max234252/TechStep/TechStep_Keypad/Bottom.jpg

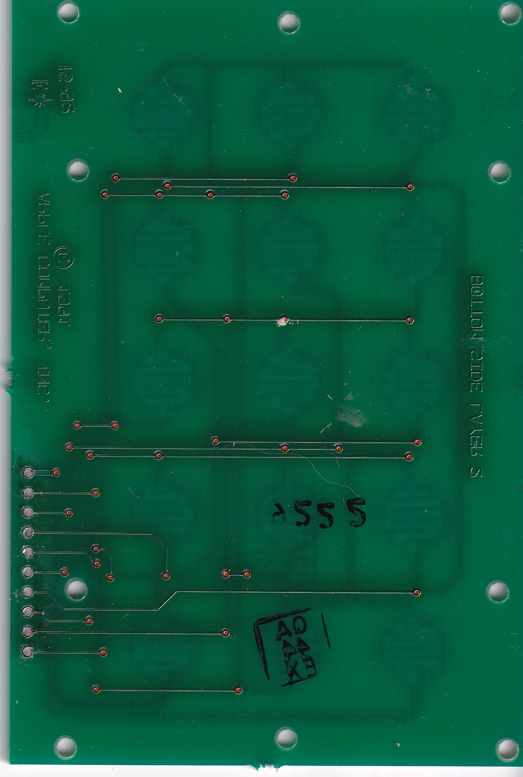
TechStep_Keypad/Bottom.jpg
