max234252/TechStep/Scans/Port Pack Scans/Bottom_Bottom.jpg

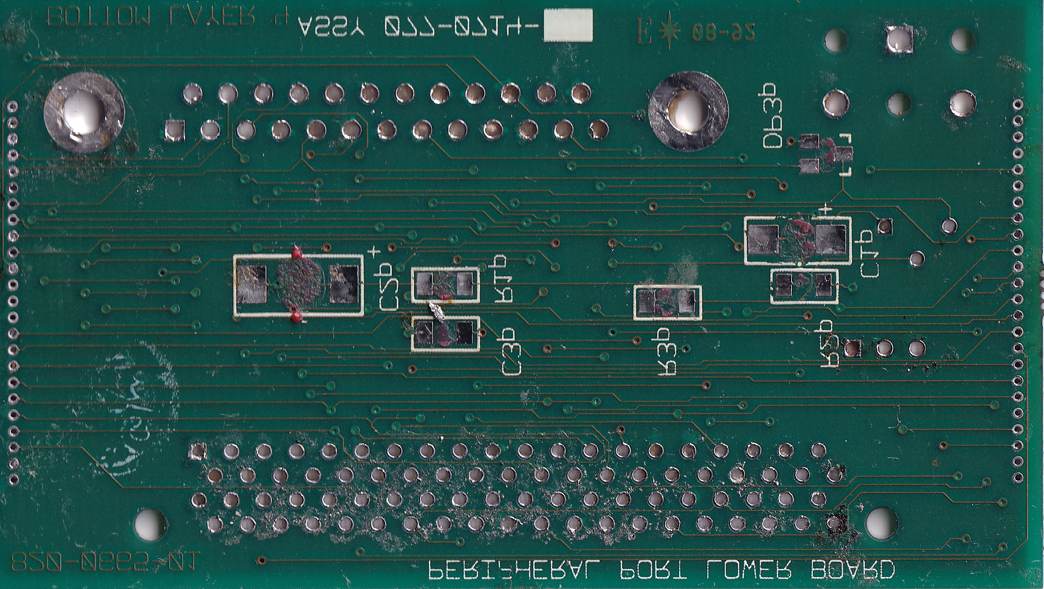
Scans/Port Pack Scans/Bottom_Bottom.jpg
