max234252/TechStep/Scans/Port Pack Scans/Bottom_Top.jpg

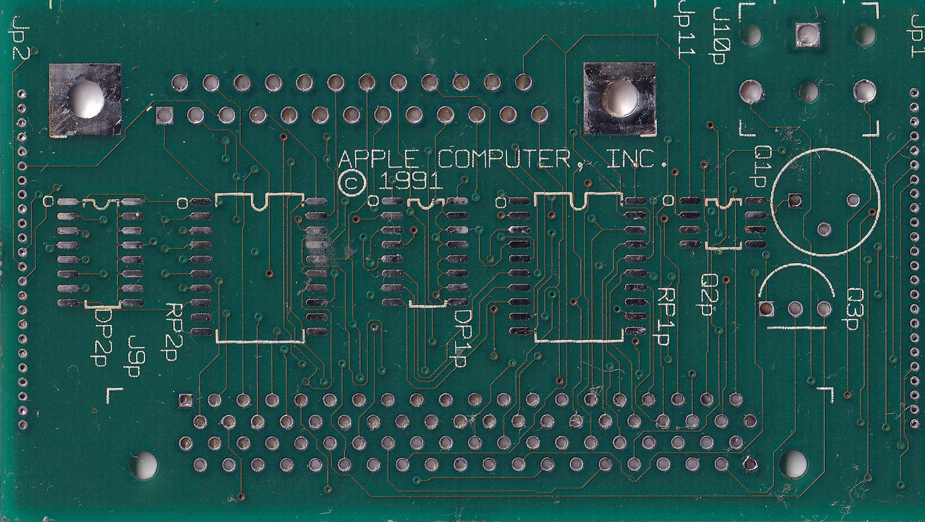
Scans/Port Pack Scans/Bottom_Top.jpg
