max234252/TechStep/Scans/Port Pack Scans/Top_Bottom.jpg

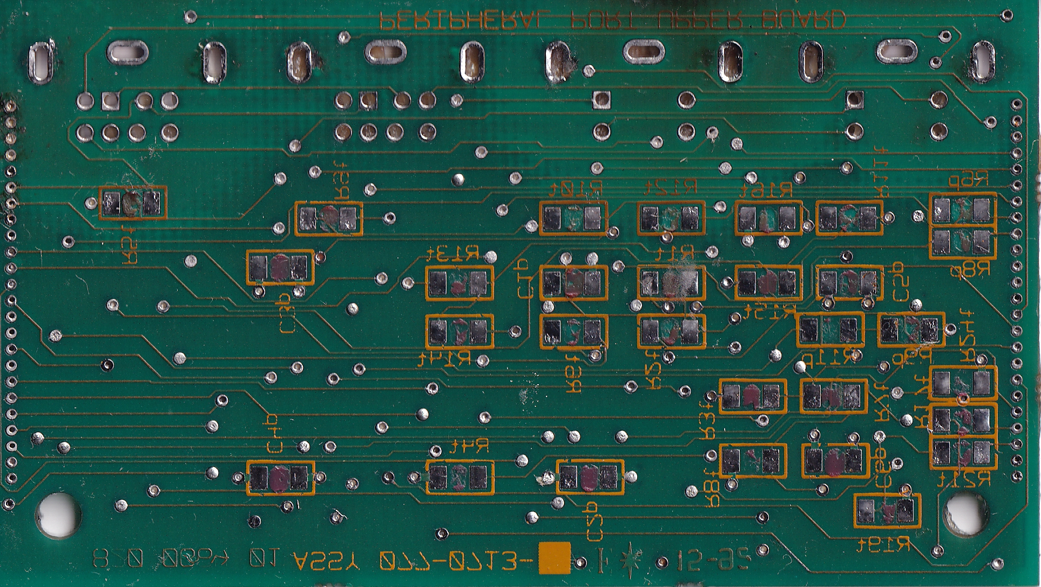
Scans/Port Pack Scans/Top_Bottom.jpg
