max234252/TechStep/Scans/Port Pack Scans/Top_Top.jpg

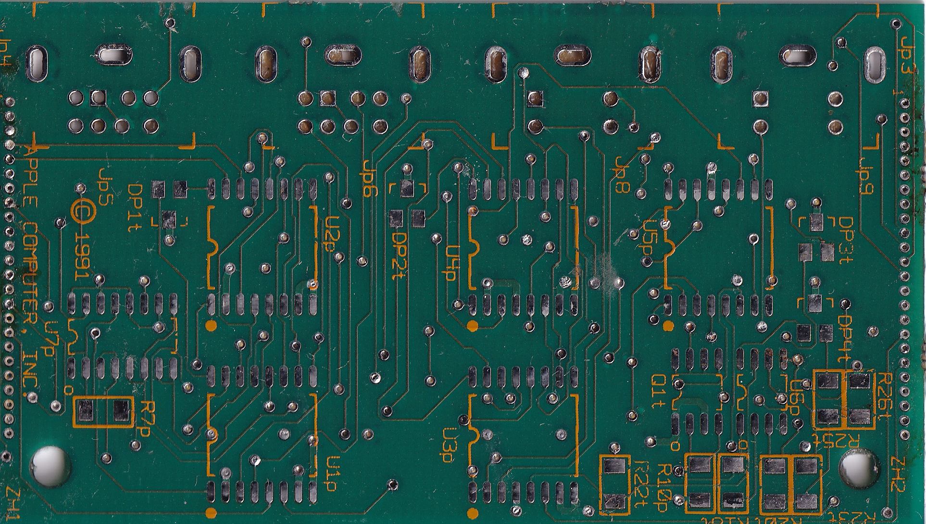
Scans/Port Pack Scans/Top_Top.jpg
