max234252/TechStep/TechStep_MLB - V1.2A - 16-09-22.pdf

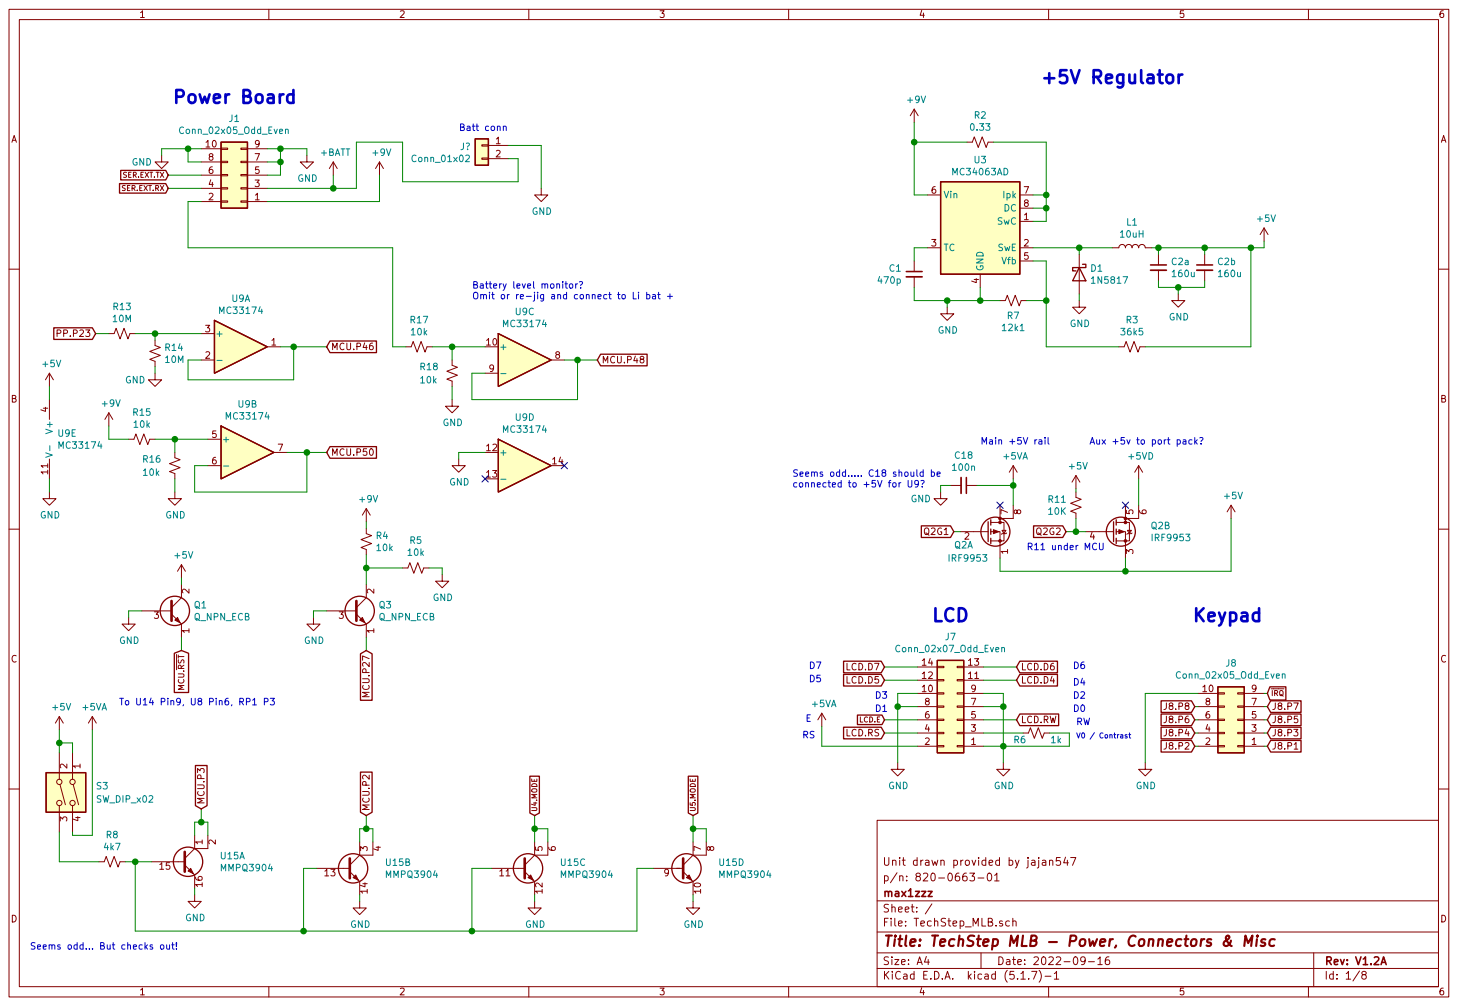
[picture p6: page 1]

Batt conn Power Board

Aux +5v to port pack?

Unit drawn provided by jajan547
File: TechStep_MLB.sch Sheet: / max1zzz p/n: 820-0663-01

Id: 1/8 Title: TechStep MLB - Power, Connectors & Misc

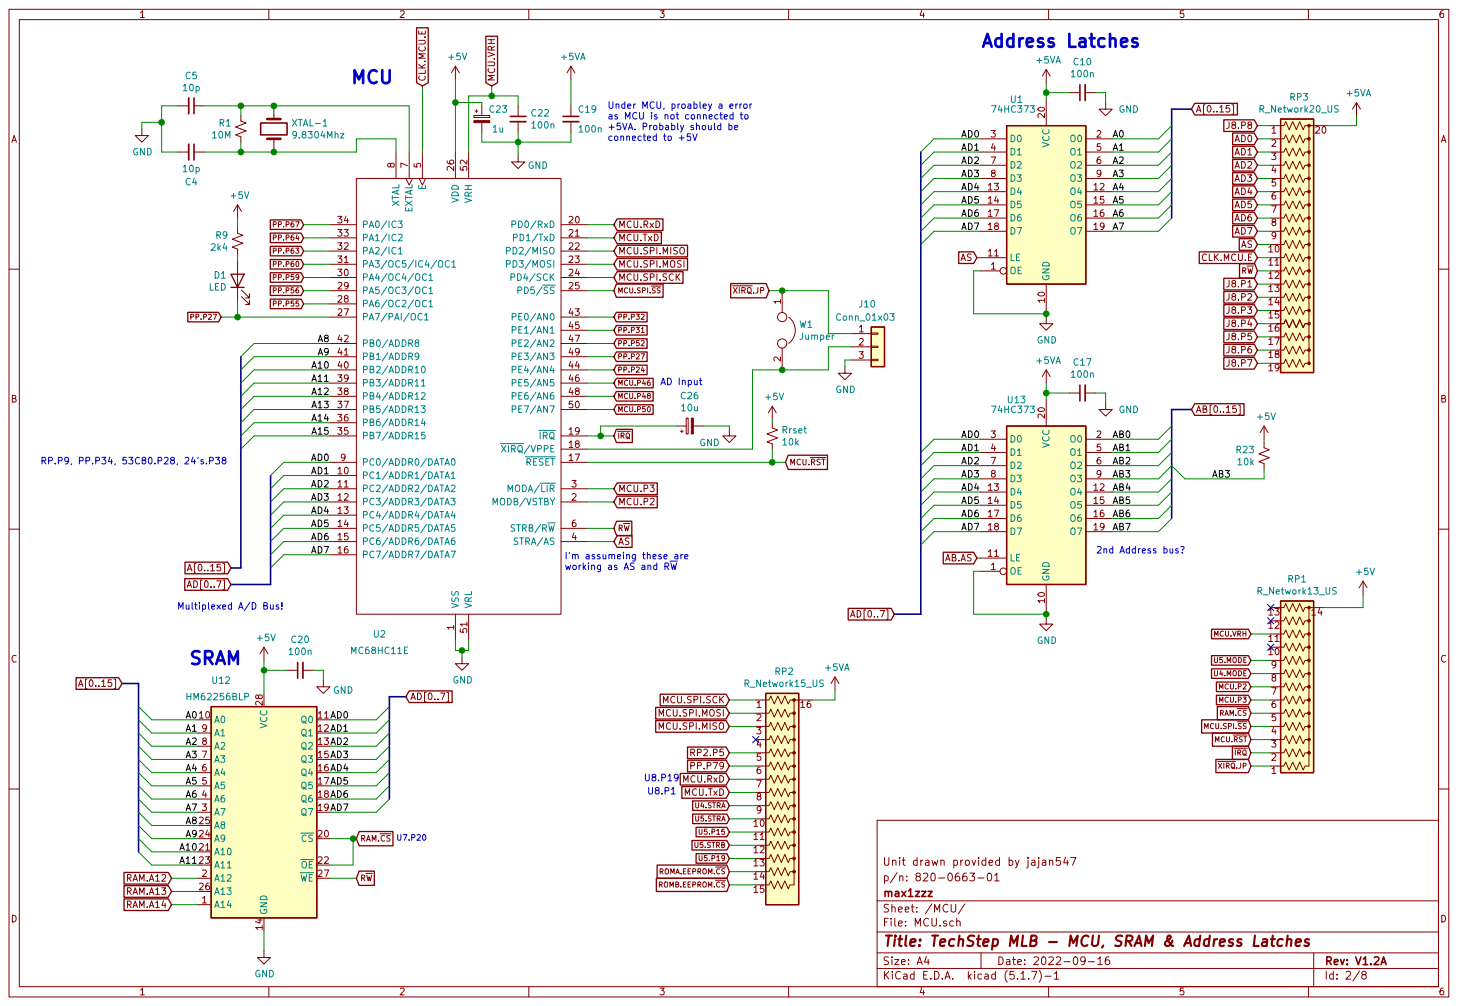
[picture p7: page 2]

Under MCU, proabley a error as MCU is not connected to +5VA. Probably should be

5 PE7/AN7 50 VRL 51 VRH 52 STRB/RW 6 EXTAL

AD Input U7.P20 RP.P9, PP.P34, 53C80.P28, 24's.P38

I'm assumeing these are
working as AS and RW

Unit drawn provided by jajan547 GND

U5.STRA MCU.SPI.MOSI

File: MCU.sch Sheet: /MCU/ max1zzz p/n: 820-0663-01

Id: 2/8 Title: TechStep MLB - MCU, SRAM & Address Latches

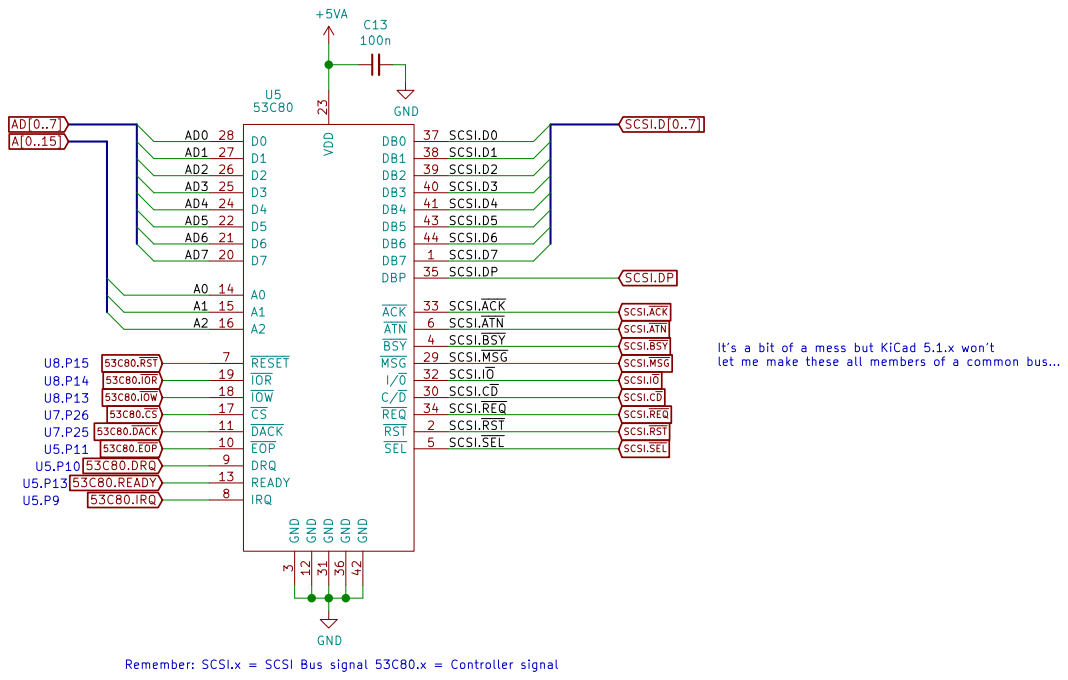
[picture p8: page 3]

SCSI.IO SCSI.D[0..7] SCSI.DP

It's a bit of a mess but KiCad 5.1.x won't

Unit drawn provided by jajan547
Id: 3/8 Title: TechStep MLB - SCSI Controller File: SCSI.sch Sheet: /SCSI/ max1zzz p/n: 820-0663-01

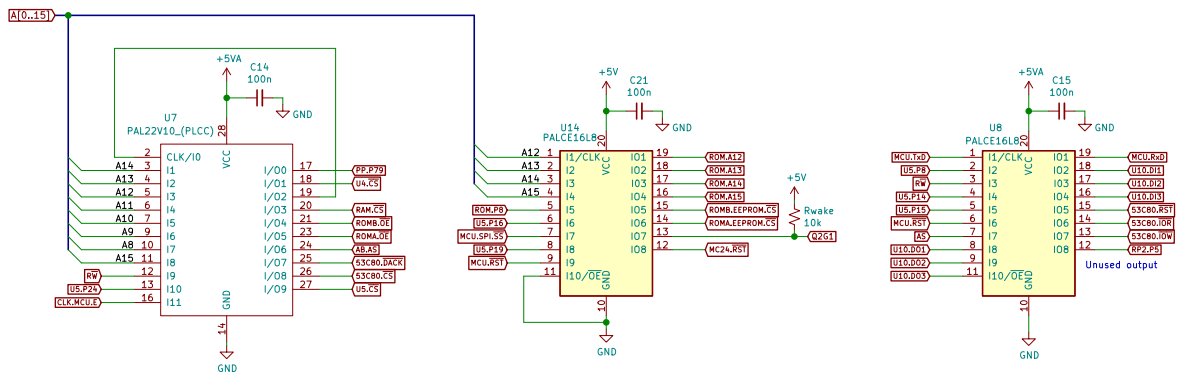
[picture p9: page 4]

File: PALs.sch Sheet: /PALs/ max1zzz p/n: 820-0663-01

Id: 4/8 Title: TechStep MLB - PAL's

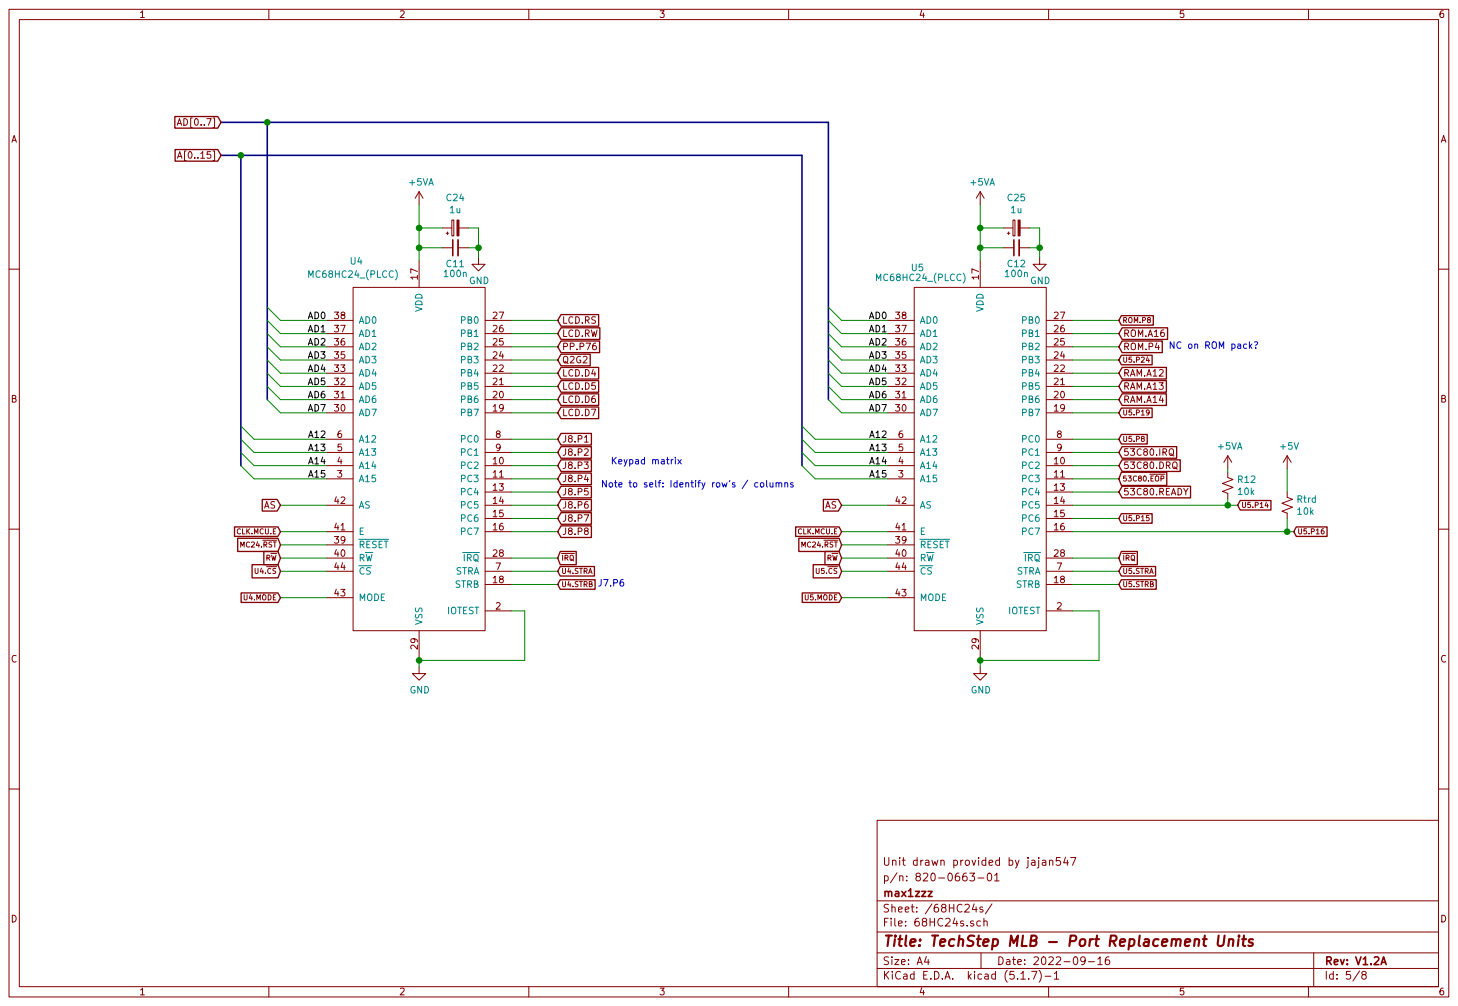
[picture p10: page 5]

Note to self: Identify row's / columns

Id: 5/8 Title: TechStep MLB - Port Replacement Units

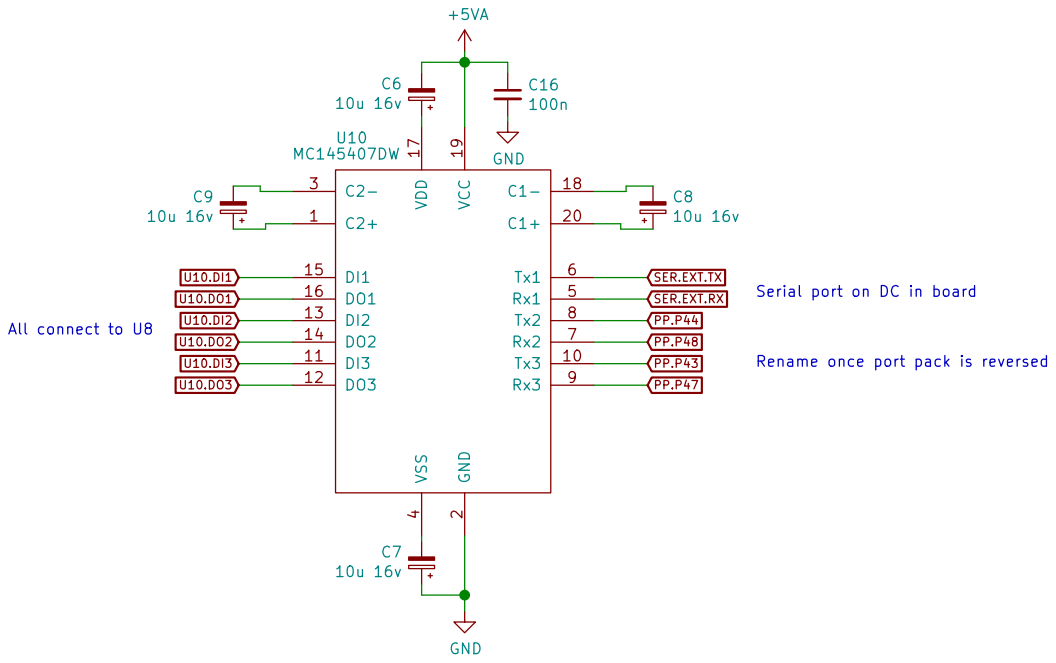
[picture p11: page 6]

Serial port on DC in board

Unit drawn provided by jajan547
Id: 6/8 Title: TechStep MLB - Serial Driver File: Serial.sch Sheet: /Serial/ max1zzz p/n: 820-0663-01

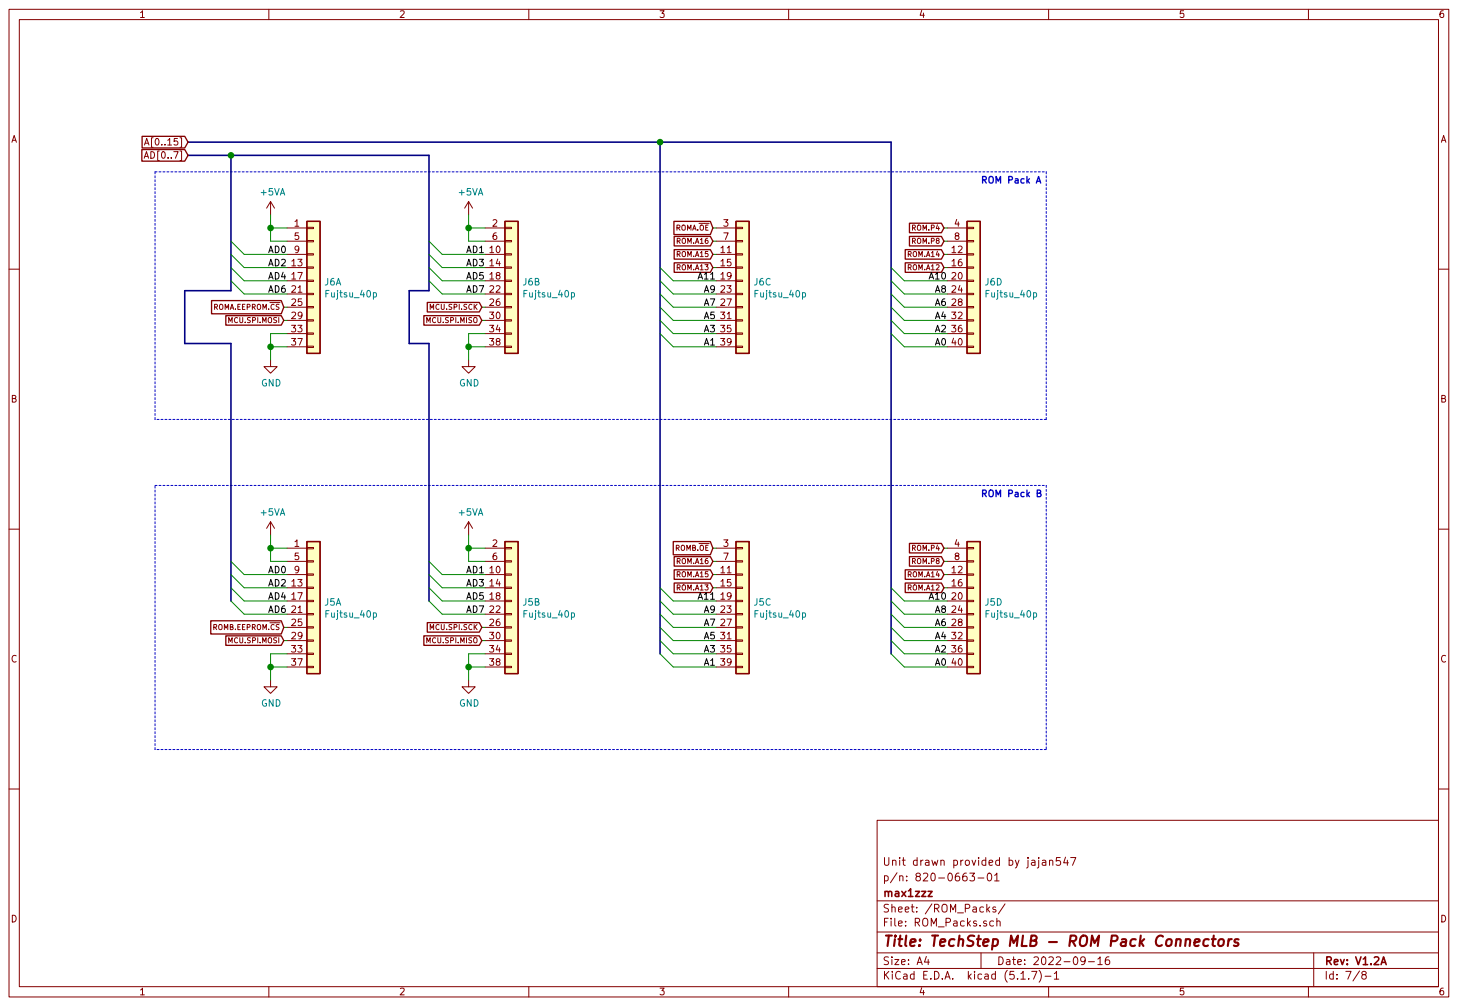
[picture p12: page 7]

ROM.A13 MCU.SPI.MOSI

+5VA GND GND GND GND

Unit drawn provided by jajan547
Sheet: /ROM_Packs/ max1zzz p/n: 820-0663-01

File: ROM_Packs.sch
Id: 7/8 Title: TechStep MLB - ROM Pack Connectors

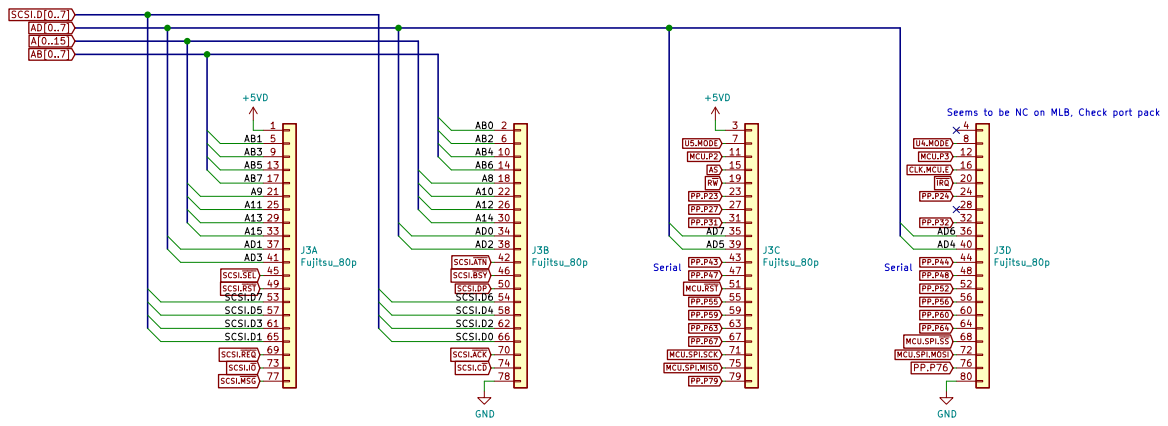
[picture p13: page 8]

Unit drawn provided by jajan547
Sheet: /Port_Pack/ max1zzz p/n: 820-0663-01

File: Port_Pack.sch
Id: 8/8 Title: TechStep MLB - Port Pack Connector
