max234252/TechStep/Port Pack/Port_Pack_Bottom.pdf

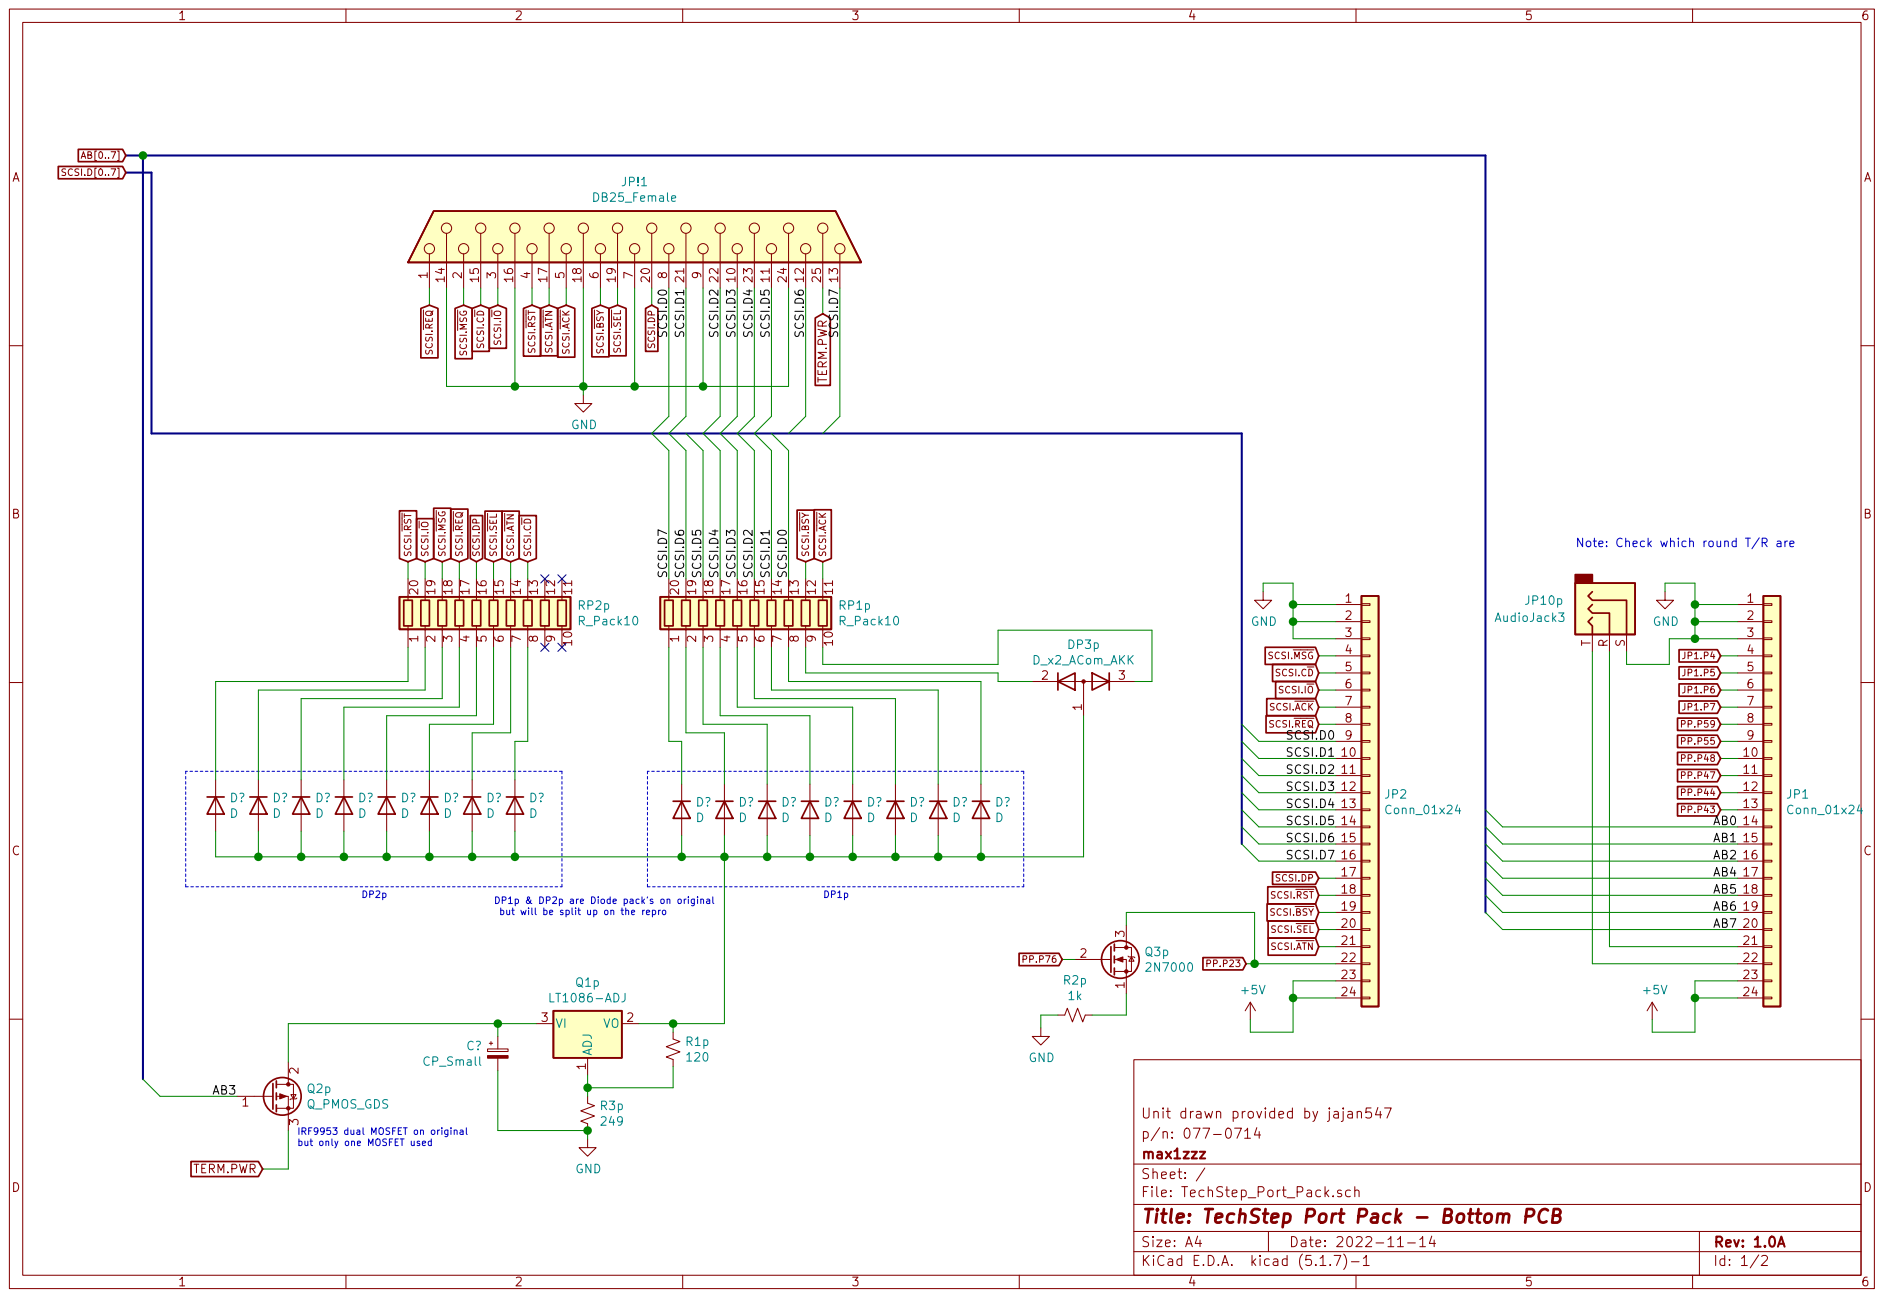
[picture p14: page 1]

SCSI.IO SCSI.CD SCSI.CD SCSI.REQ
SCSI.REQ SCSI.IO SCSI.REQ

SCSI.SEL SCSI.MSG SCSI.ACK SCSI.ACK

SCSI.ACK SCSI.IO

Note: Check which round T/R are

Unit drawn provided by jajan547
File: TechStep_Port_Pack.sch Sheet: / max1zzz p/n: 077-0714

IRF9953 dual MOSFET on original but only one MOSFET used

Id: 1/2 Title: TechStep Port Pack - Bottom PCB

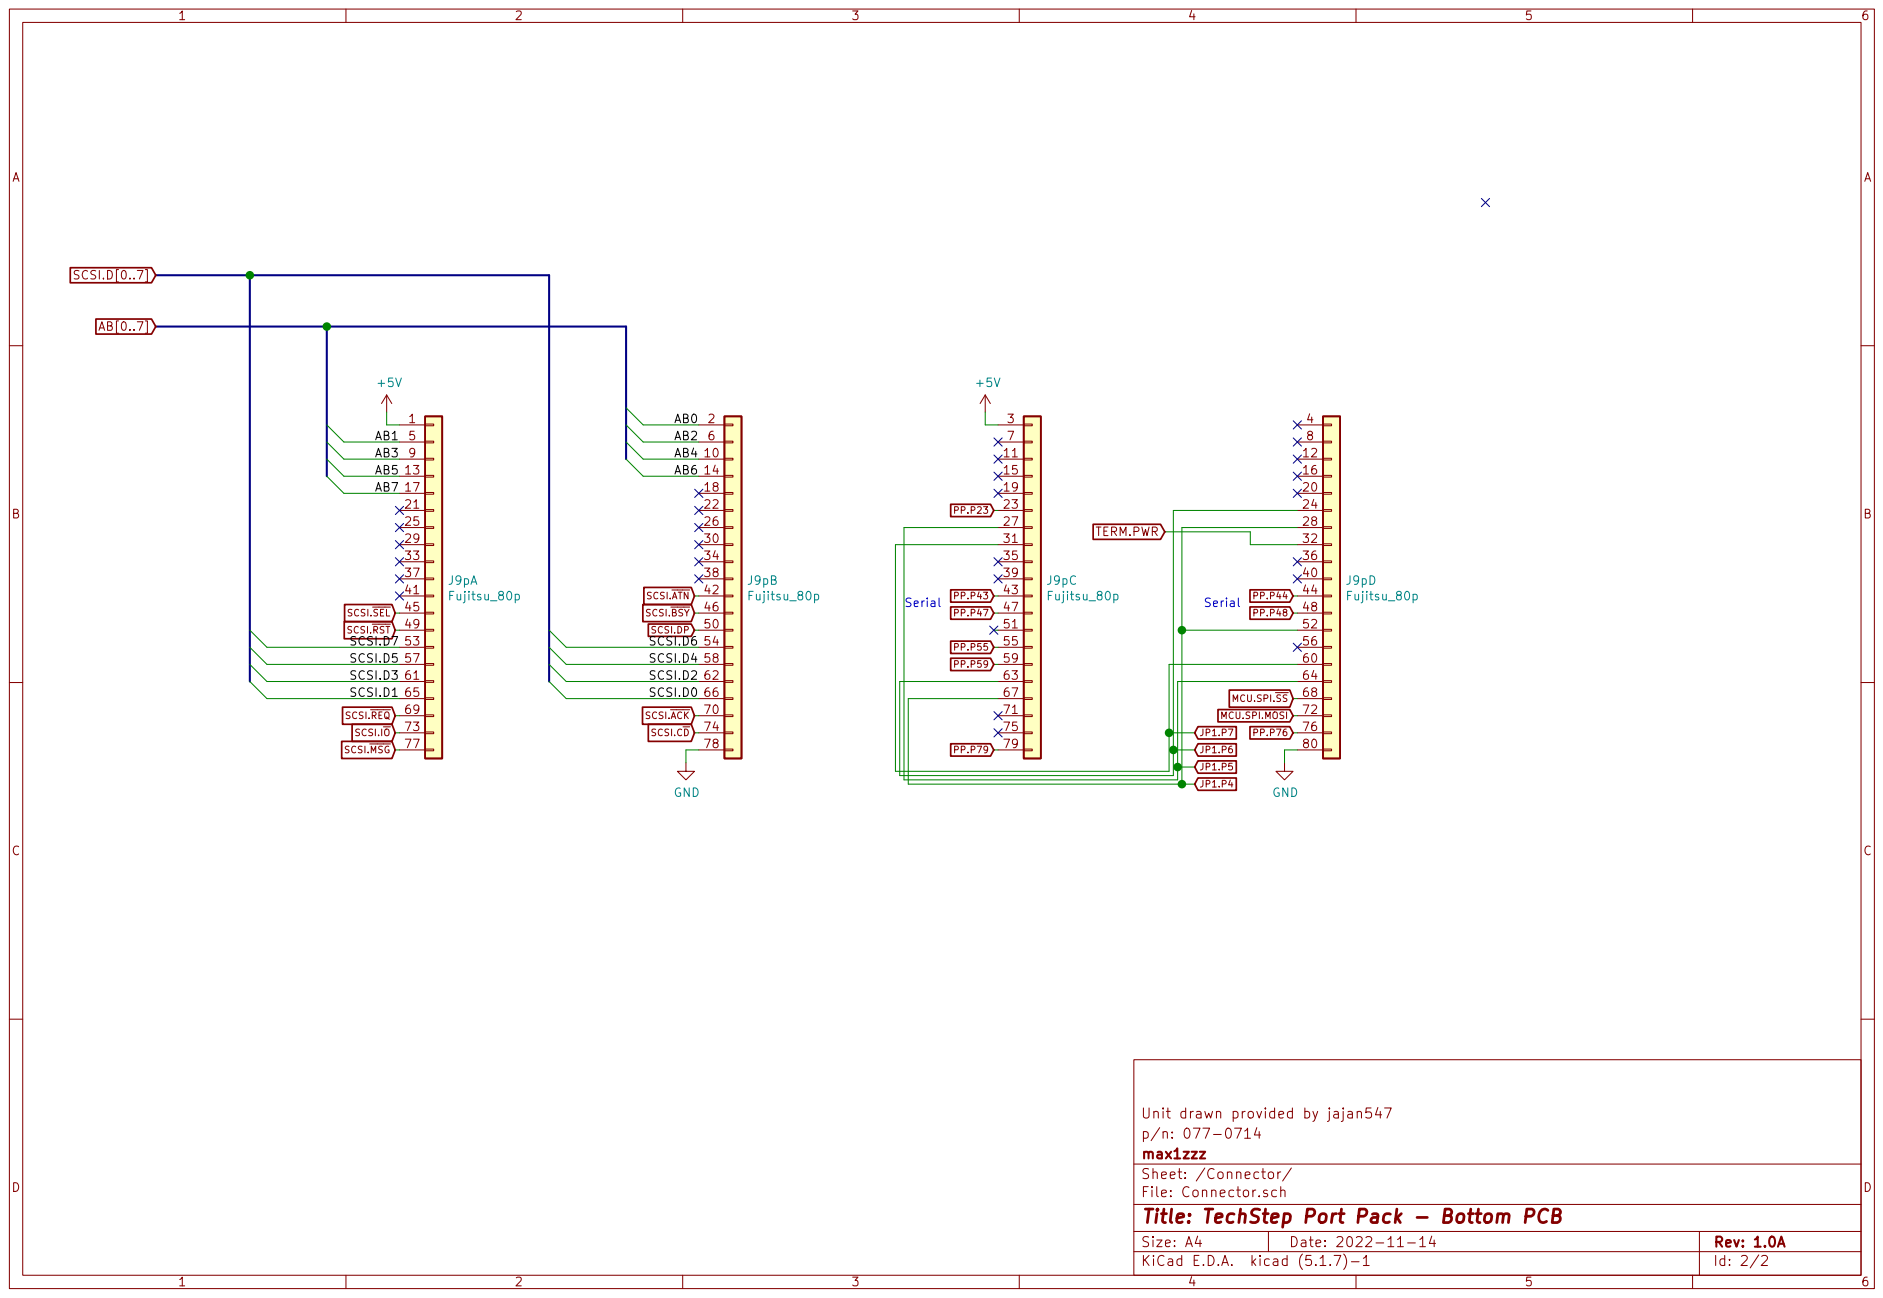
[picture p15: page 2]

Unit drawn provided by jajan547
File: Connector.sch Sheet: /Connector/ max1zzz p/n: 077-0714

Id: 2/2 Title: TechStep Port Pack - Bottom PCB
