max234252/TechStep/Port Pack/Port_Pack_Top.pdf

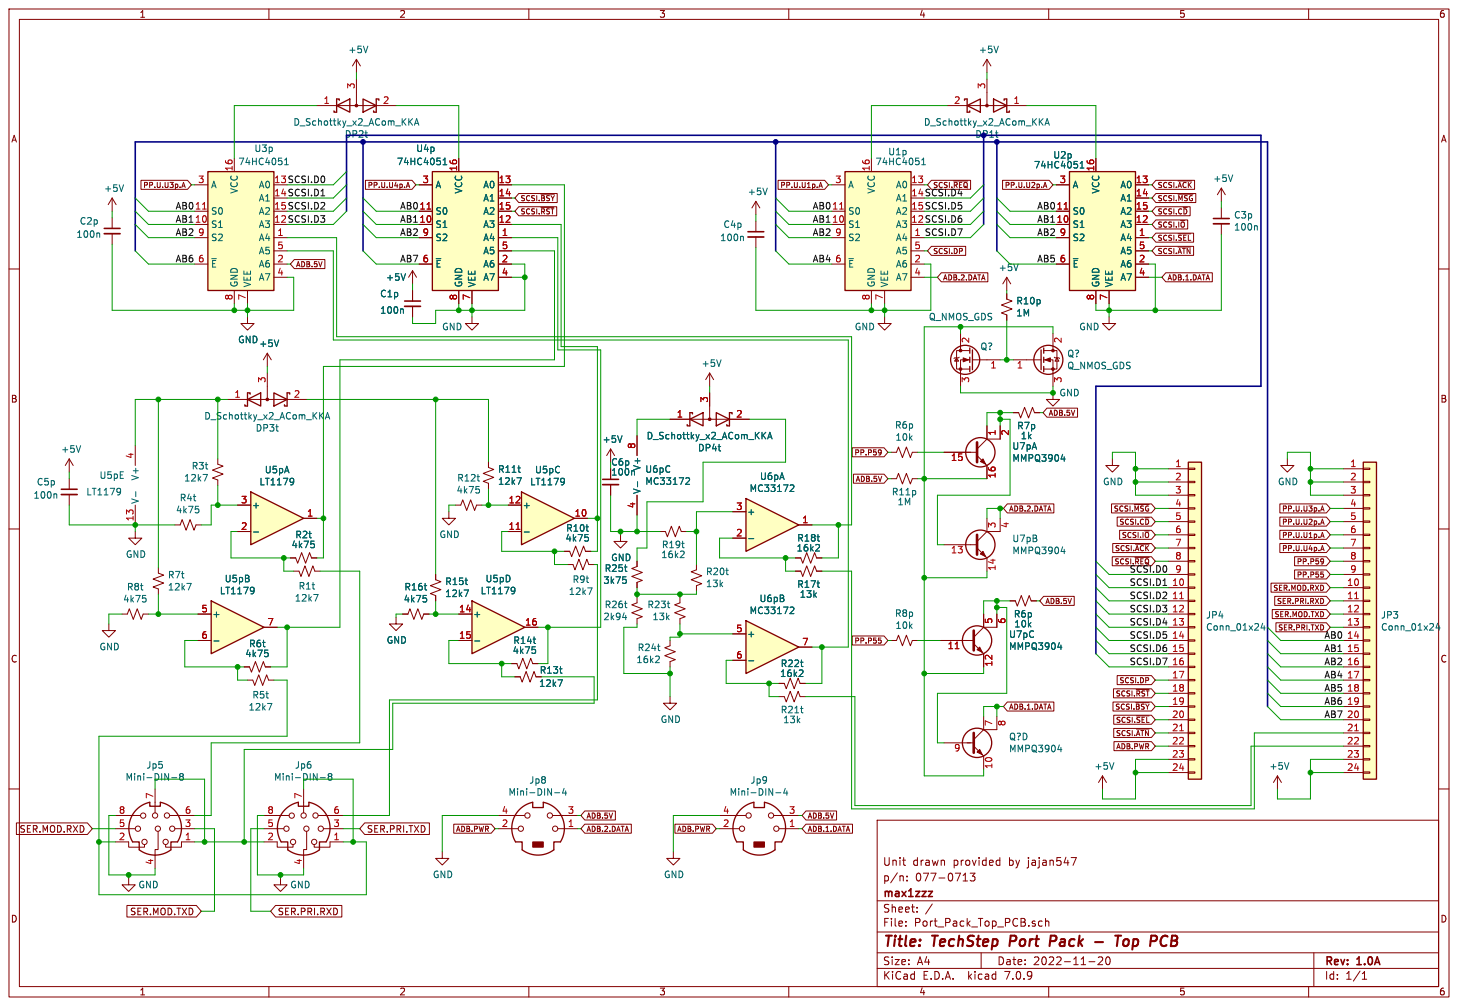
[picture p16: page 1]

SCSI.~{MSG} SCSI.~{REQ} SCSI.DP

SCSI.~{REQ} ADB.2.DATA

SCSI.C~{D} SCSI.I~{O} ADB.PWR

PP.P55 SER.MOD.TXD
SER.MOD.RXD

SER.PRI.RXD

Id: 1/1 Title: TechStep Port Pack - Top PCB
