max234252/TechStep/(list of files, drawings)

Other design files:
TechStep_Keypad/TechStep_Keypad.lay6
